buzzler/appleii-bluetooth-joystick/(commit log)

2026-05-16 fix: remove forgetBluetoothKeys to persist paired controllers, add Korean README
    - Removed BP32.forgetBluetoothKeys() so paired controllers survive reboots
    - Added Korean translation as README.md and moved English to README.en.md
    - Added fork attribution to original kirbyfrugia/appleii-bluetooth-joystick
    [appleii-bluetooth-joystick.ino]
2026-05-16 docs: add IC datasheets and schematic analysis vs datasheets
    - Add datasheets/ with 5 IC PDFs (ESP32-WROOM-32E, MCP4161, SN74HCT245,
    2N7000, 1N5817) for offline reference
    - Add schematic/회로도_분석.md: detailed analysis comparing the current
    schematic against each datasheet's reference design
    - Identifies ESP32 VDD33/EN floating, missing decoupling caps, etc.
    - Verifies failsafe circuit (R5 gate pulldown, R6 OE pullup) is correct
    - Provides step-by-step KiCad modification guide for bare-module design
    (LDO, EN RC, strapping pins, UART programming header)
    - Verifies WiFi is genuinely disabled (code + Bluepad32 + ESP32 default)
    - Update .gitignore to exclude schematic/.his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
